chadblinman/MC624_remote/photos/MC624_Completed_05.JPG

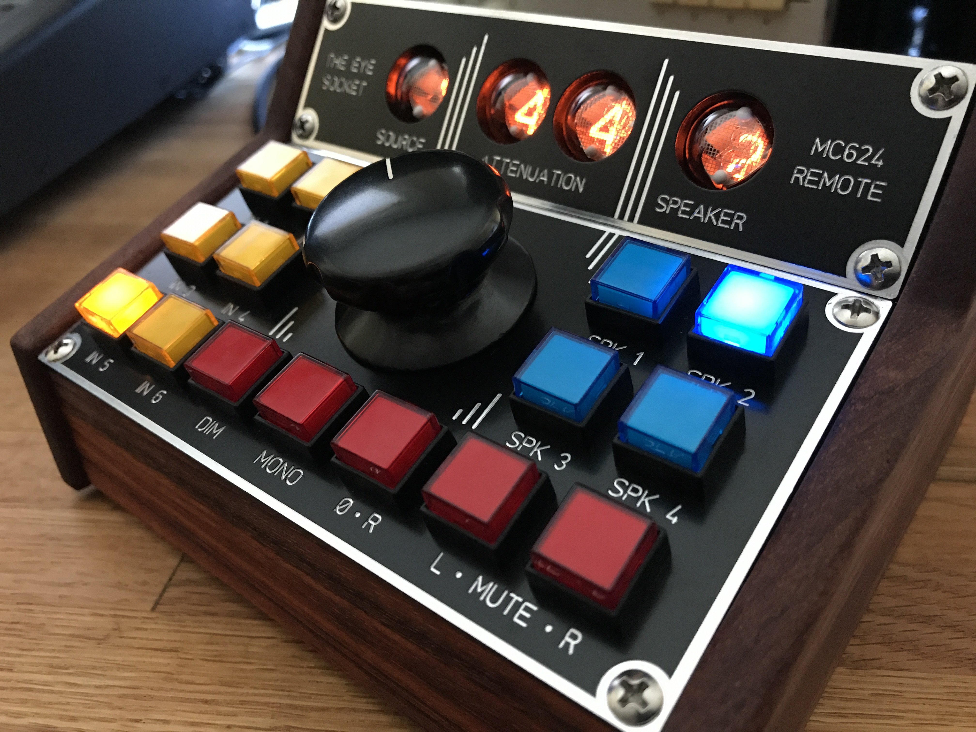
photos/MC624_Completed_05.JPG
