chadblinman/MC624_remote/photos/MC624_Completed_15.JPG

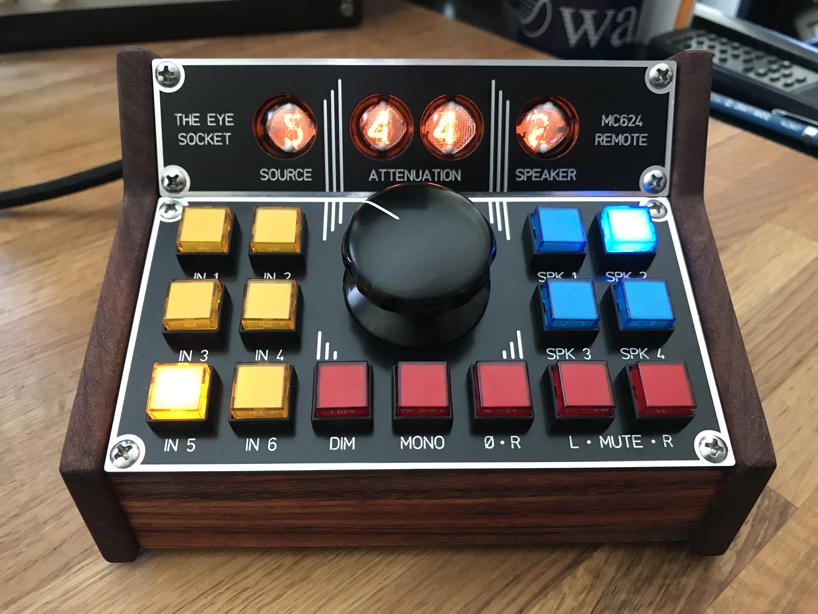
photos/MC624_Completed_15.JPG
