chadblinman/MC624_remote/photos/MC624_Completed_02.JPG

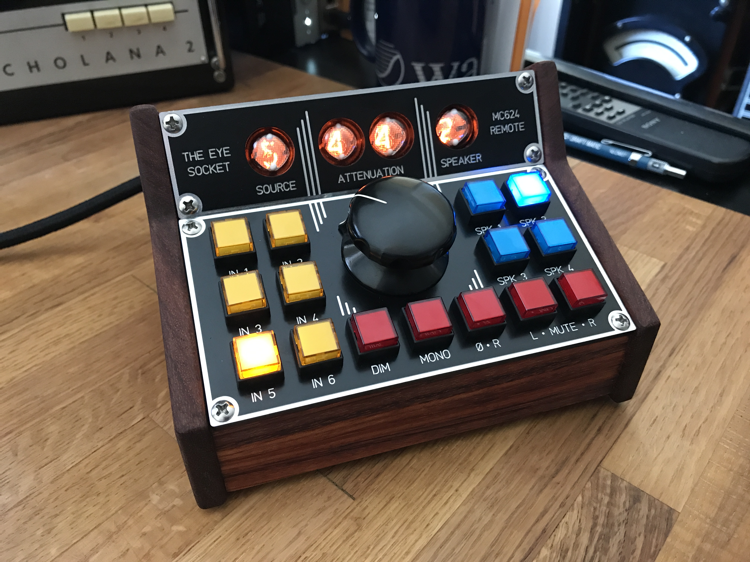
photos/MC624_Completed_02.JPG
