chadblinman/MC624_remote/photos/MC624_Completed_06.JPG

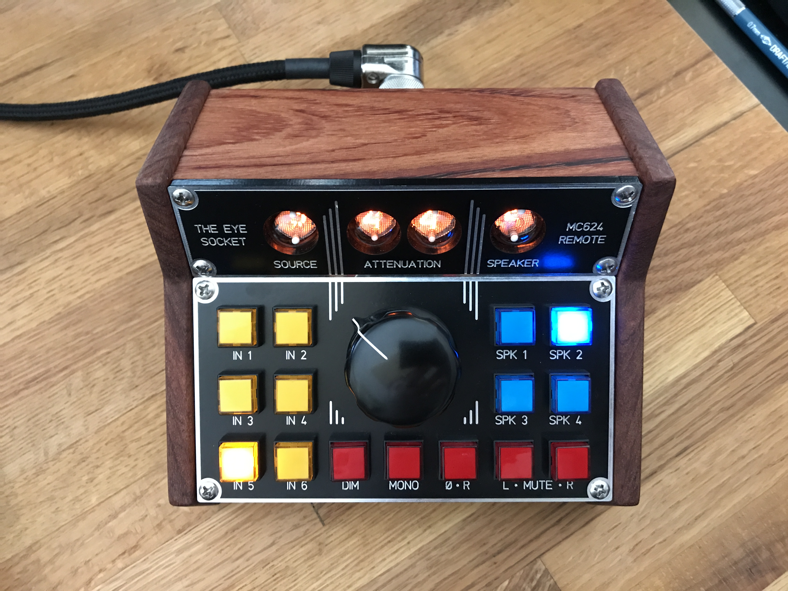
photos/MC624_Completed_06.JPG
