chadblinman/MC624_remote/photos/MC624_Completed_07.JPG

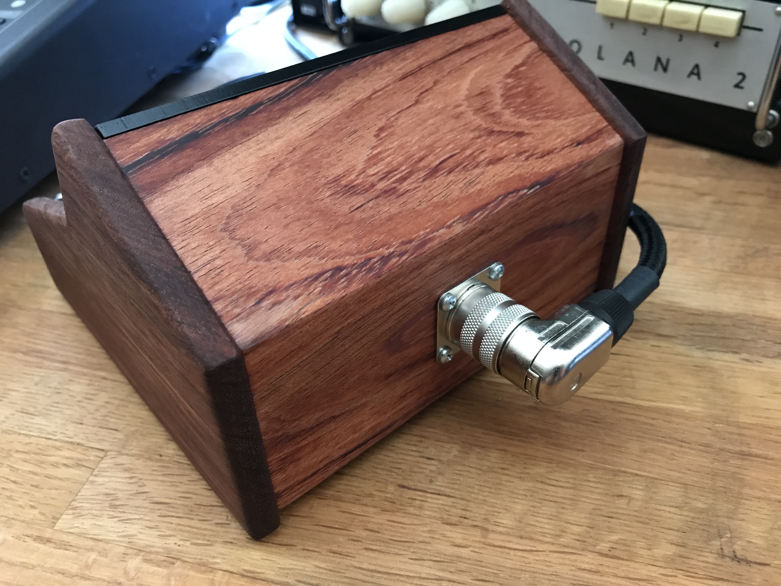
photos/MC624_Completed_07.JPG
