chadblinman/MC624_remote/photos/MC624_Completed_08.JPG

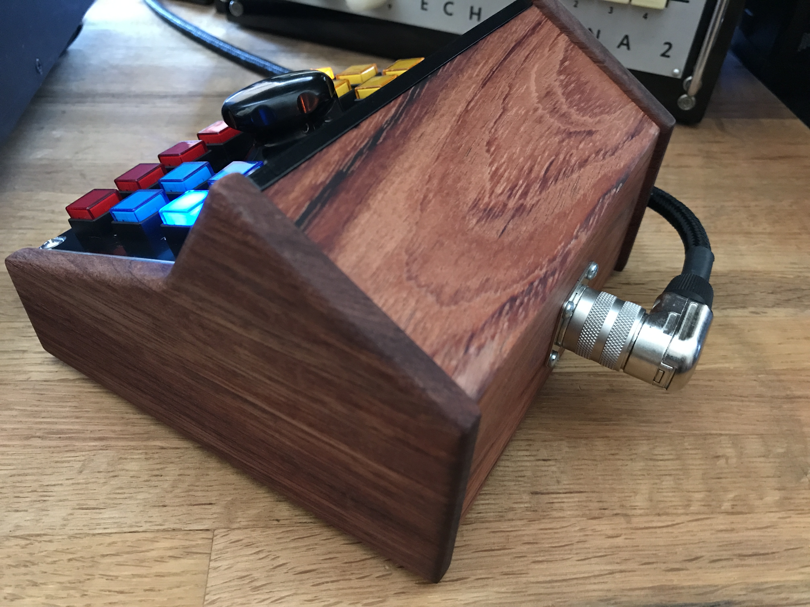
photos/MC624_Completed_08.JPG
