chadblinman/MC624_remote/photos/MC624_Completed_09.JPG

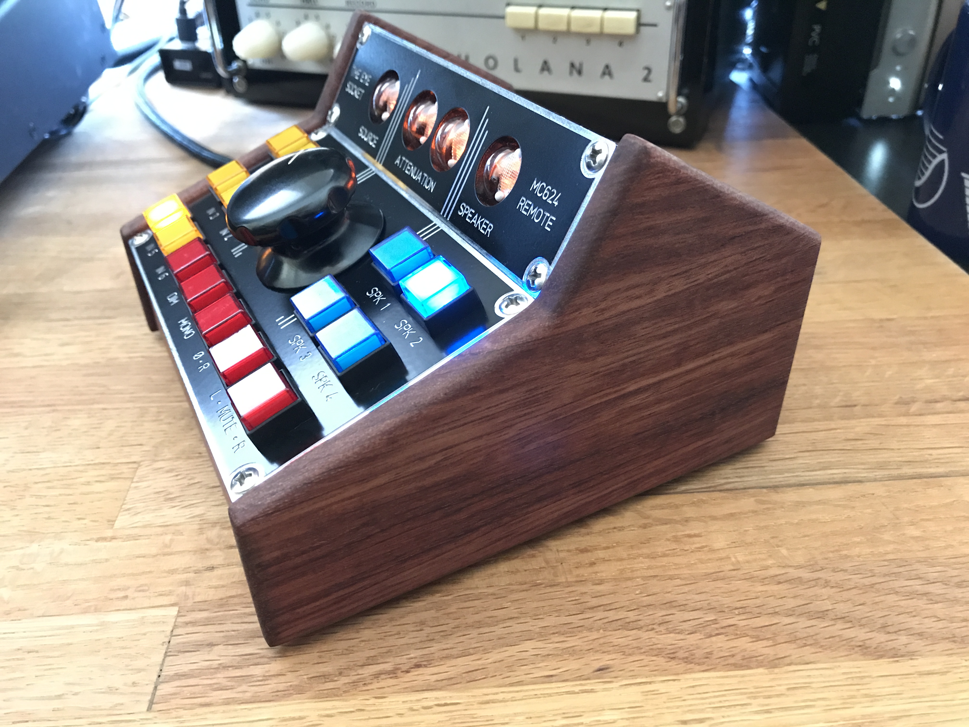
photos/MC624_Completed_09.JPG
