chadblinman/MC624_remote/photos/MC624_Completed_12.JPG

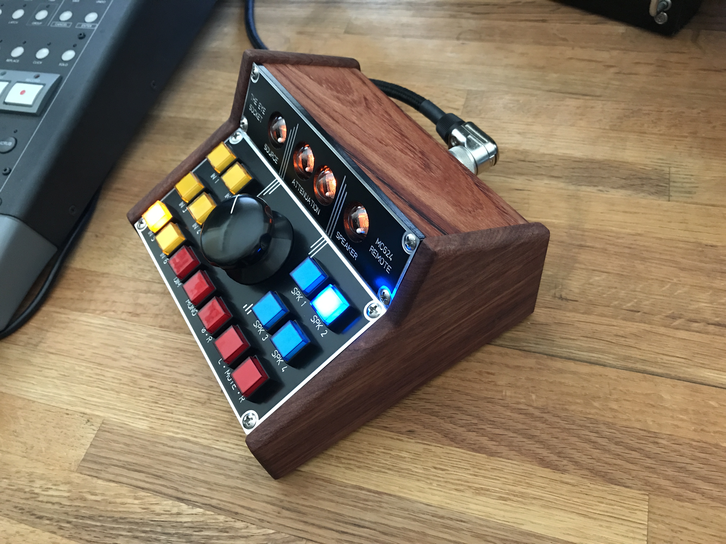
photos/MC624_Completed_12.JPG
