chadblinman/MC624_remote/panels and enclosure/MC624 Remote Enclosure v04.pdf

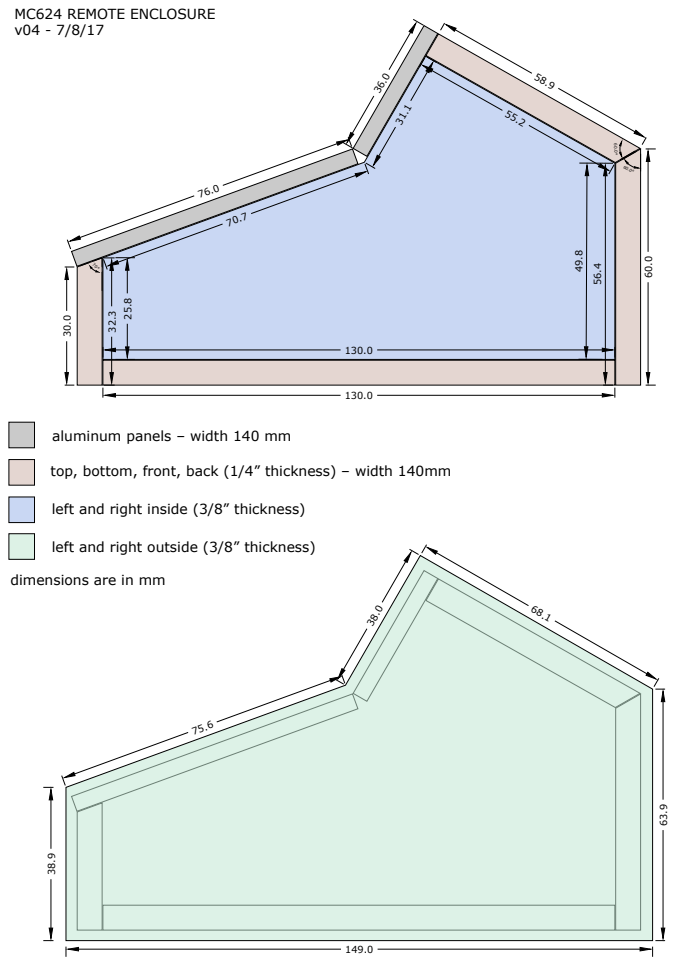
[picture p9: page 1]
MC624 REMOTE ENCLOSURE v04 - 7/8/17

aluminum panels – width 140 mm

top, bottom, front, back (1/4” thickness) – width 140mm

left and right inside (3/8” thickness)

left and right outside (3/8” thickness)

dimensions are in mm

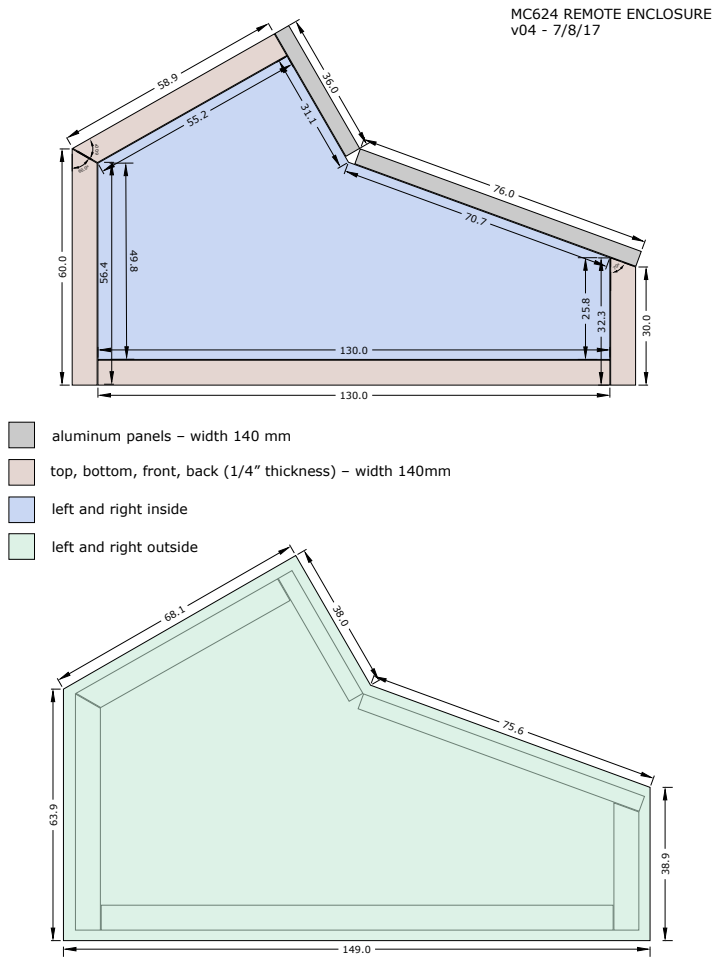
[picture p10: page 2]

aluminum panels – width 140 mm

top, bottom, front, back (1/4” thickness) – width 140mm

left and right inside

left and right outside

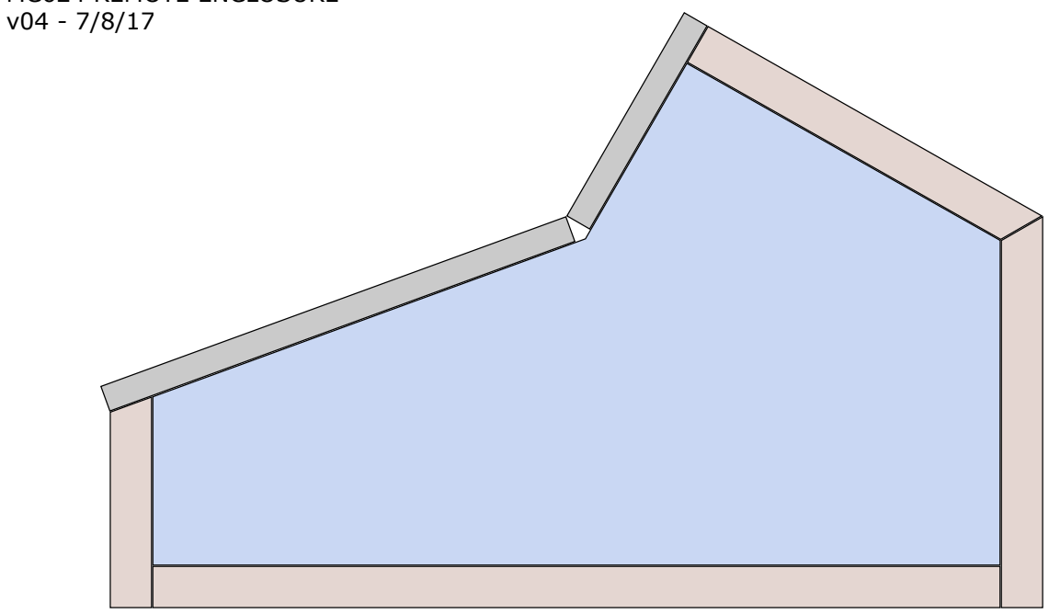
[picture p11: figure]

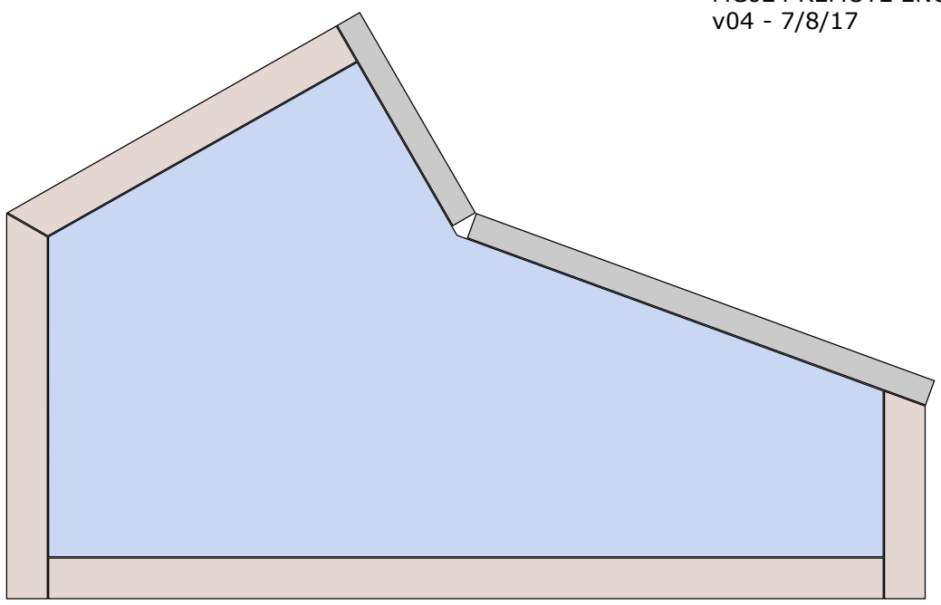
[picture p12: figure]
