chadblinman/MC624_remote/panels and enclosure/MC624_remote_R28_B.pdf

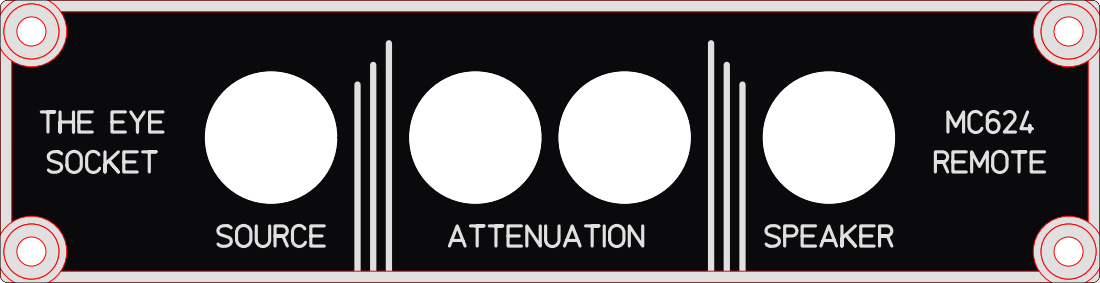
[picture p13: page 1]
