chadblinman/MC624_remote/panels and enclosure/MC624_remote_R29_A.pdf

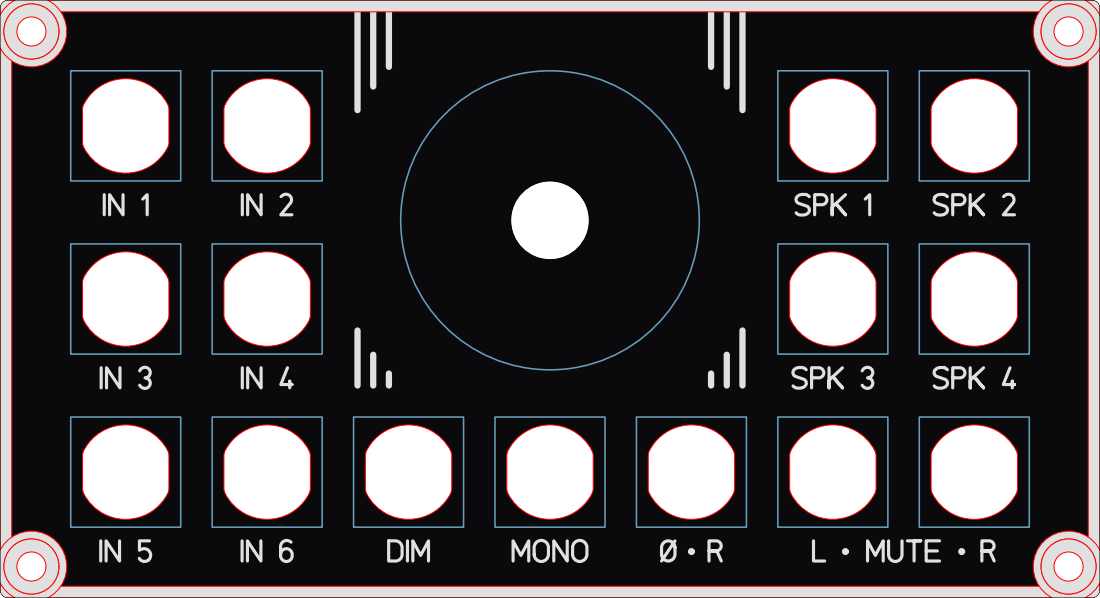
[picture p14: page 1]
