chadblinman/MC624_remote/(commit log)

2017-06-18 Add files via upload
    New photos for version 3 prototype, the (probably) final design. Updated Arduino code (v11) has improved smoothing for the analog pot and other improvements.
2017-10-07 Add files via upload
    Photos of the completed device.
2017-10-07 Add files via upload
    Version 14 Arduino sketch for the Mega 2560.
    Requires libraries ResponsiveAnalogRead.h, SoftwareSerial.h, EEPROM.h
2017-10-07 Add files via upload
    Panel designs in PDF and FPD (Front Panel Designer) formats.
    Enclosure dimensions in PDF format.
2017-11-11 wiring diagrams
    My (handwritten) wiring diagrams.
